vonsivers/word-clock/pics/IMG_20171213_205209.jpg

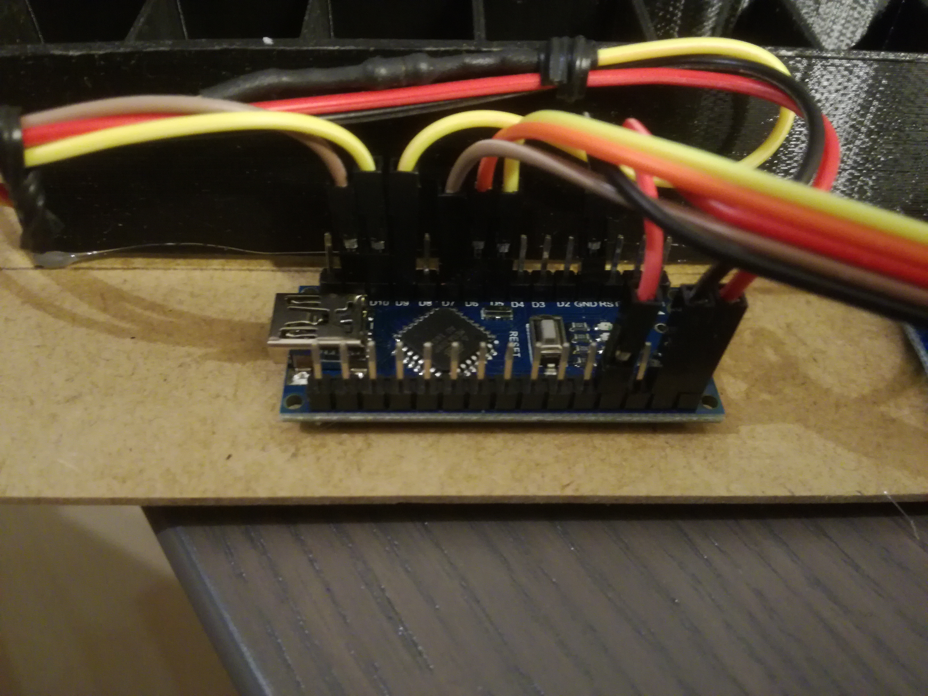
pics/IMG_20171213_205209.jpg
