vonsivers/word-clock/pics/IMG_20171213_215705.jpg

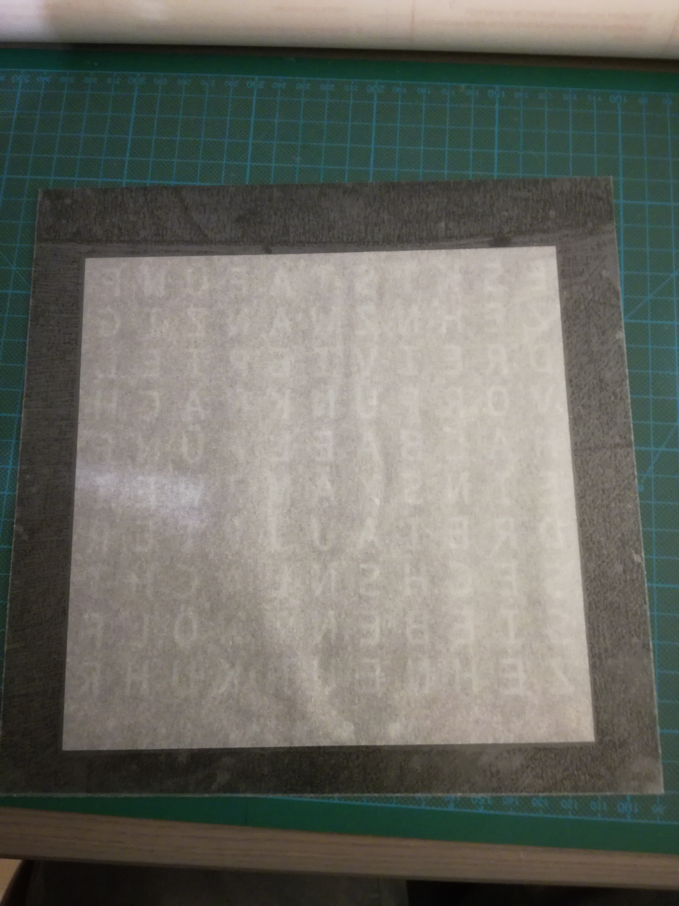
pics/IMG_20171213_215705.jpg
