vonsivers/word-clock/pics/IMG_20171213_201749.jpg

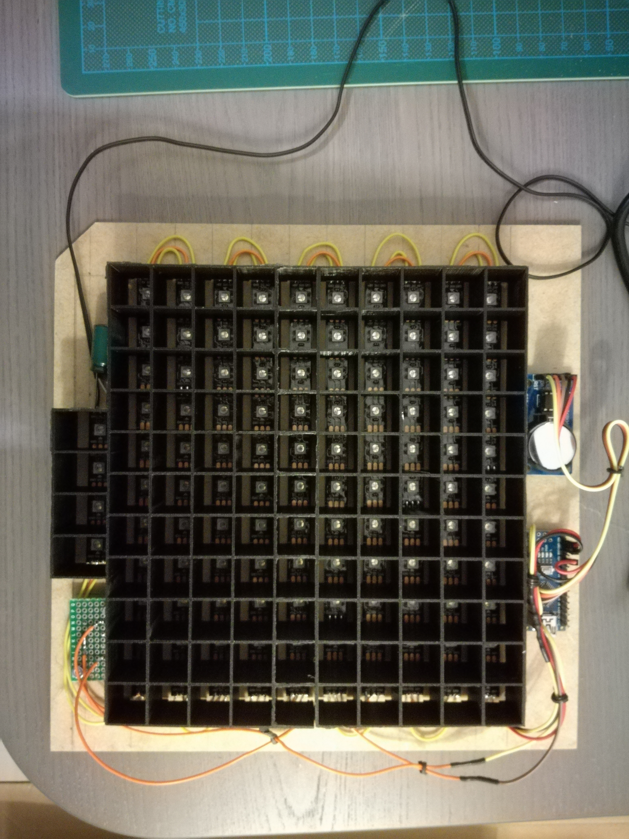
pics/IMG_20171213_201749.jpg
