vonsivers/word-clock/pics/IMG_20171213_205219.jpg

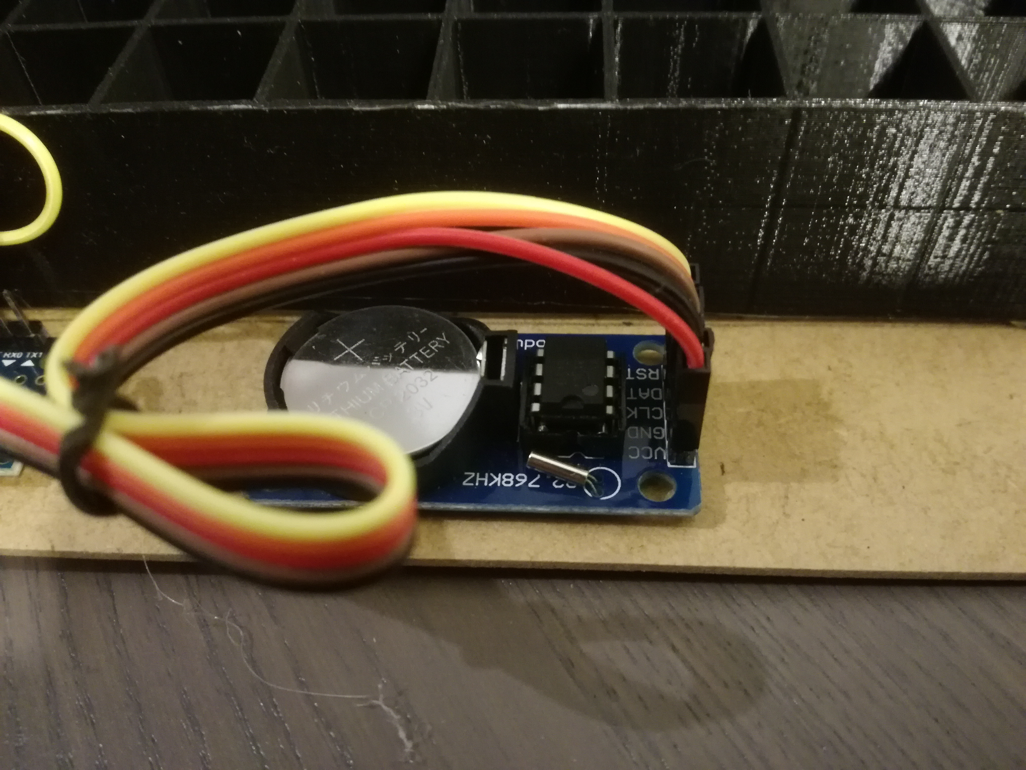
pics/IMG_20171213_205219.jpg
