vonsivers/word-clock/pics/IMG_20171213_211320.jpg

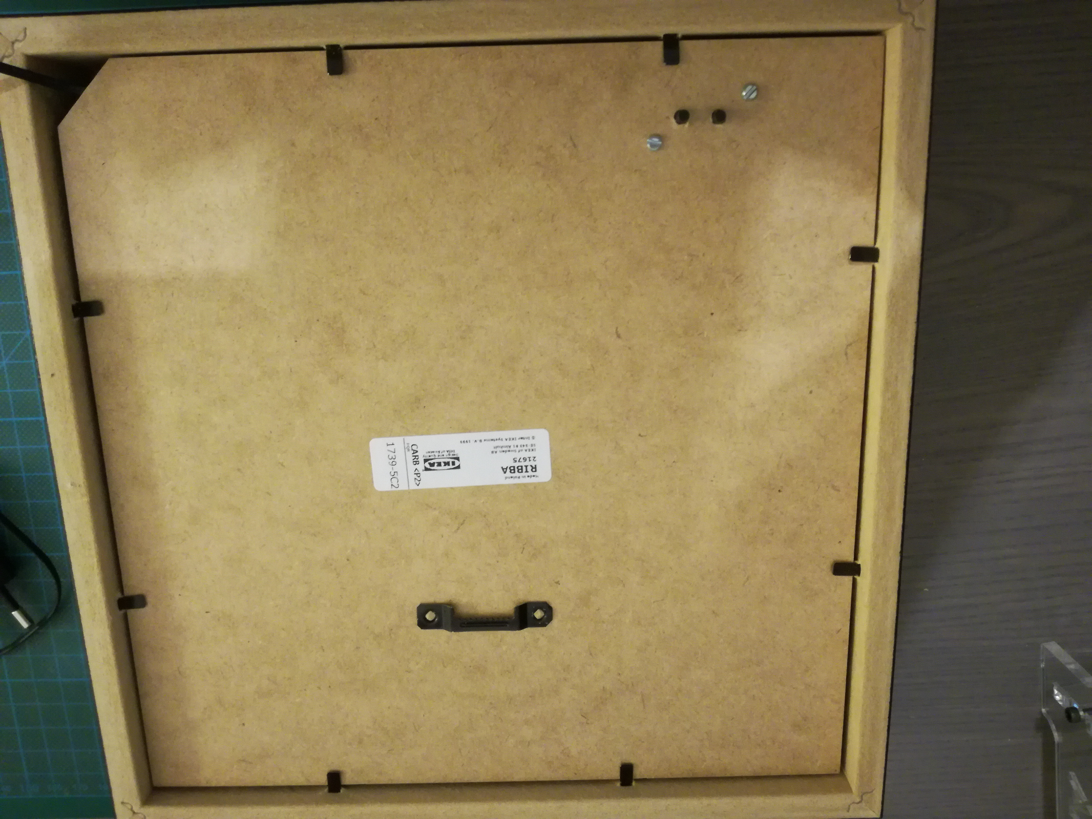
pics/IMG_20171213_211320.jpg
