vonsivers/word-clock/pics/IMG_20171214_003248.jpg

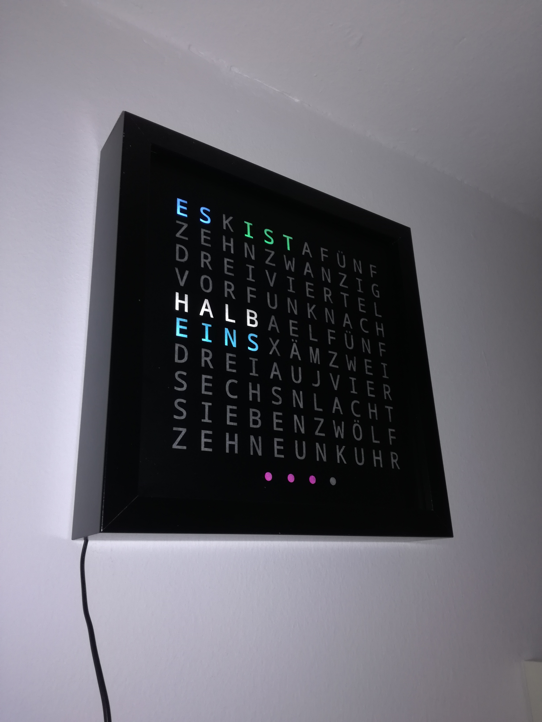
pics/IMG_20171214_003248.jpg
