vonsivers/word-clock/BoM.ods

Common Items
Quantity | Item | Source | Comments
114 pc (5 m strip) | WS2812B, 60 LEDs/m | https://www.amazon.de/BTF-LIGHTING-WS2812B-adressierbare-Streifen-NichtWasserdicht/dp/B01CDTEJBG
1 | IKEA Ribba (23 x 23 cm) | http://www.ikea.com/de/de/catalog/products/00378436/#/40378401
1 | ELCO, 1000 µF, 6.3V | https://www.conrad.de/de/elektrolyt-kondensator-radial-bedrahtet-35-mm-1000-f-63-v-20-o-x-h-8-mm-x-15-mm-europe-chemicon-eky-6r3ell102mh1-1505577.html | recommended to support PSU but not mandatory
1 | Resistor, 470 Ohm | https://www.conrad.de/de/kohleschicht-widerstand-470-axial-bedrahtet-0204-01-w-5-1-st-400211.html | anything between 300-500 Ohm, recommended but not mandatory
1 | Power Supply, 5V, >0.5 A | https://www.amazon.de/Wicked-Chili-Pro-Netzteil-Smartphone-schwarz/dp/B004GXUKD4
1 | USB cable | https://www.reichelt.de/?ACTION=3;ARTICLE=152673;SEARCH=usb%20textil%20kab
1 | Arduino Nano | https://www.amazon.de/XCSOURCE-Atmega-Controller-Arduino-TE359/dp/B015MGHH6Q
Options
1 | DS1302 RTC Module | https://www.amazon.de/DS1302-Echtzeituhr-Temperatursensor-Arduino-Raspberry/dp/B06XCR1WK2?s=computers
1 | DS3231 RTC Module | https://www.amazon.de/dp/B01M2B7HQB/ref=psdc_1626220031_t1_B06XCR1WK2 | alternative to DS1302 with better accuracy
2 | Push Button Dip Switch | https://www.conrad.de/de/drucktaster-12-vdc-005-a-1-x-ausein-yst-1103a-tastend-1-st-1386951.html | for setting time manually
1 | DCF77 Modul (EB6180B1COB77K5A1) | https://www.amazon.de/Empfangsmodul-Funkzeit-Funkuhr-Arduino-Antenne/dp/B014I7VUS6?s=aps | for automatic time setting, runs on max. 3.6 V
1 | DCF77 Modul (BN641138) | https://www.conrad.de/de/dcf-empfaenger-modul-641138-passend-fuer-serie-c-control-641138.html | more noisy than EB6180B1COB77K5A1 but runs on broad voltage range
1 | Arduino Micro Pro, 5V, 16 Mhz | https://www.amazon.de/dp/B075MD6591/ref=pe_3044161_189395811_TE_3p_dp_1 | One could also build the DCF77 clock without RTC using an arduino micro. The arduino micro clock has quarz crystal necessary for DCF signal filtering
