vonsivers/word-clock/technical drawings/grid.dxf

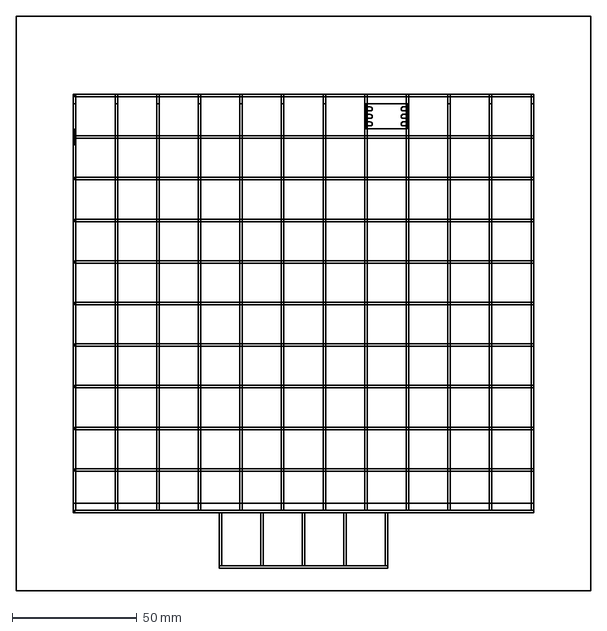
[picture p7: CAD file, 2018-01-08]
technical drawings/grid.dxf
230.0 x 230.0 mm
