vonsivers/word-clock/technical drawings/gitter.stl

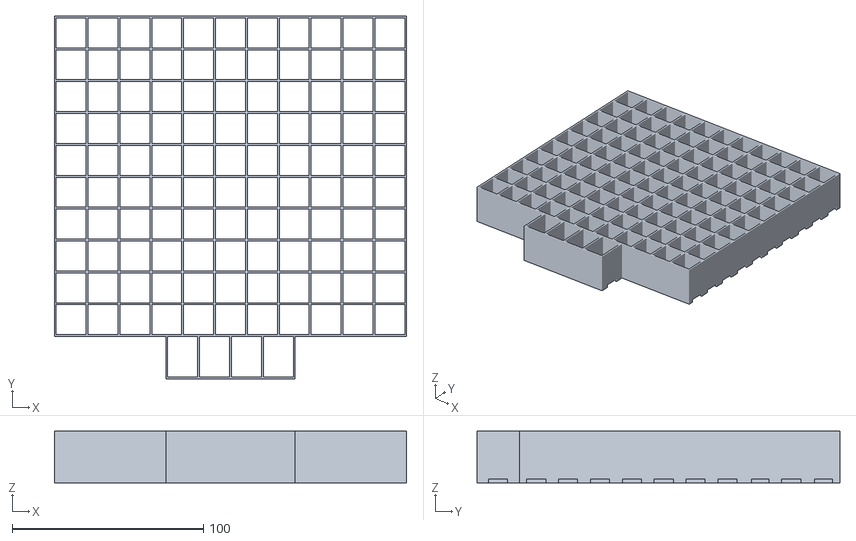
[picture p8: CAD file, 2018-01-08]
technical drawings/gitter.stl
184.3 x 189.8 x 27.0
