vonsivers/word-clock/technical drawings/gitter2_modified.stl

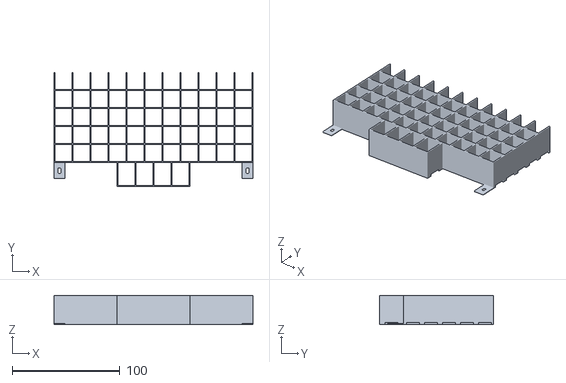
[picture p9: CAD file, 2018-01-04]
technical drawings/gitter2_modified.stl
184.3 x 105.5 x 27.0
