vonsivers/word-clock/technical drawings/gitter1_modified.stl

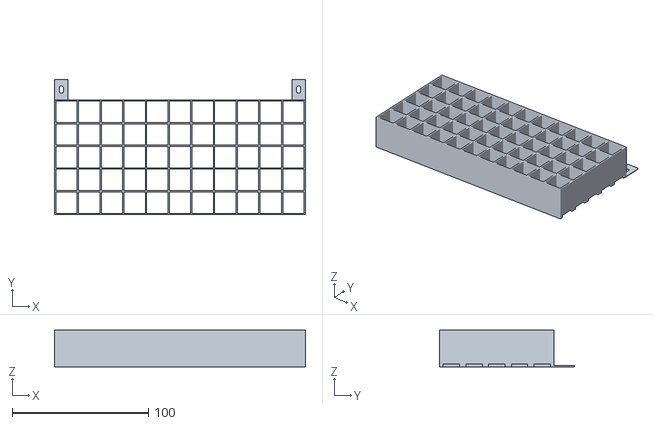
[picture p10: CAD file, 2018-01-04]
technical drawings/gitter1_modified.stl
184.3 x 99.3 x 27.0
