vonsivers/word-clock/technical drawings/gitter1.stl

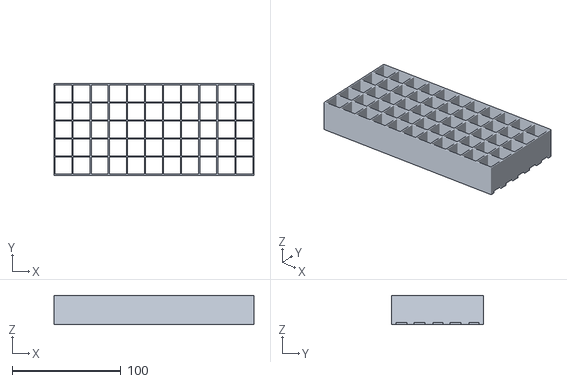
[picture p11: CAD file, 2017-12-27]
technical drawings/gitter1.stl
184.3 x 84.3 x 27.0
