vonsivers/word-clock/(list of files, cad)

Other CAD files:
technical drawings/gitter2.stl
