vonsivers/word-clock/DS3231-DCF77_word_clock/DS3231-DCF77 schematic.pdf

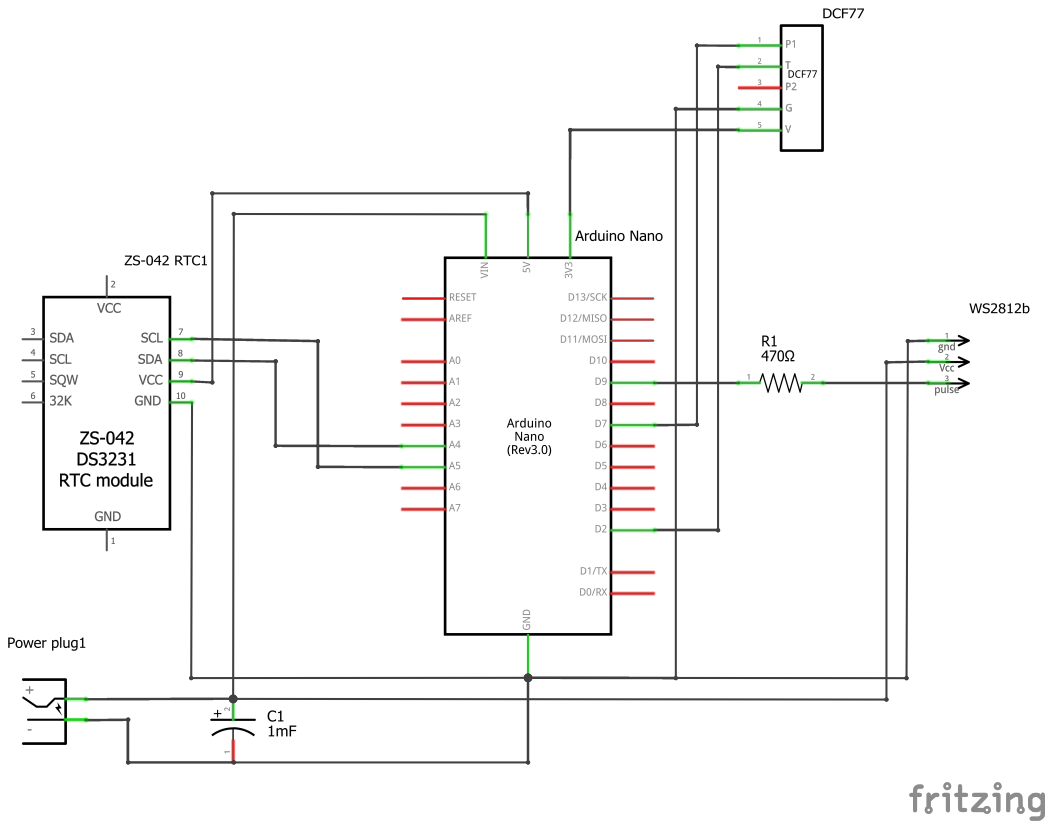
[picture p12: page 1]
