vonsivers/word-clock/DS1302_word_clock/word clock schematic.pdf

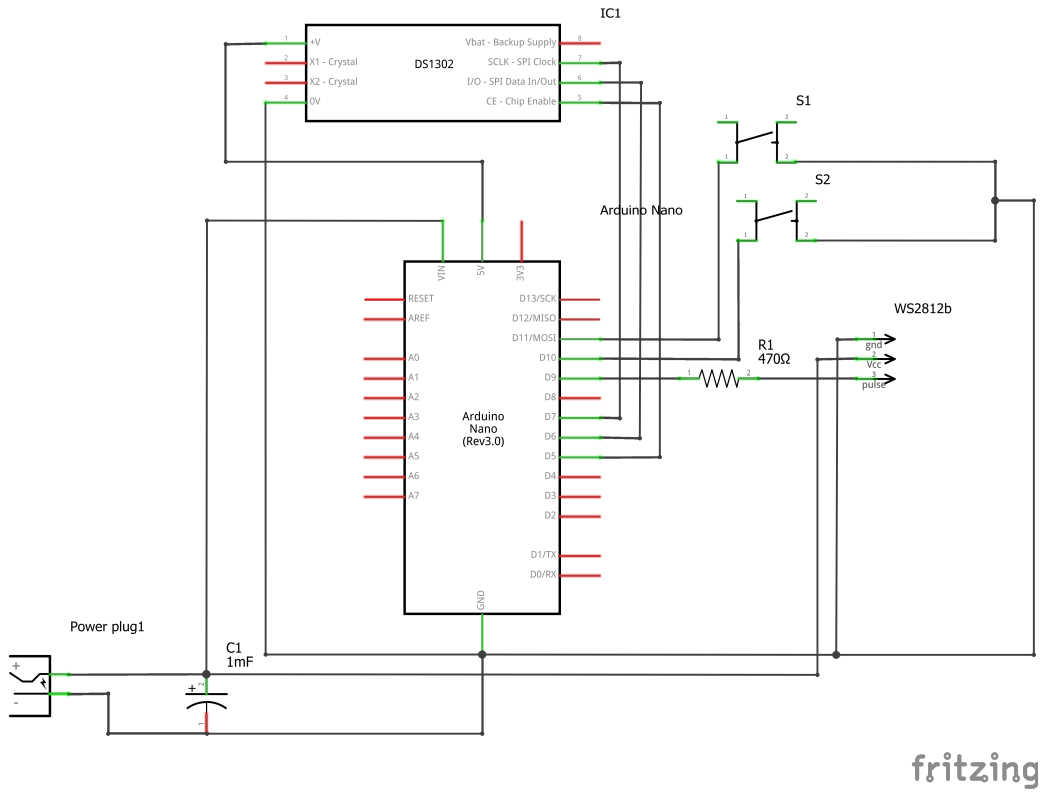
[picture p13: page 1]
