vonsivers/word-clock/technical drawings/word clock back panel drawing.pdf

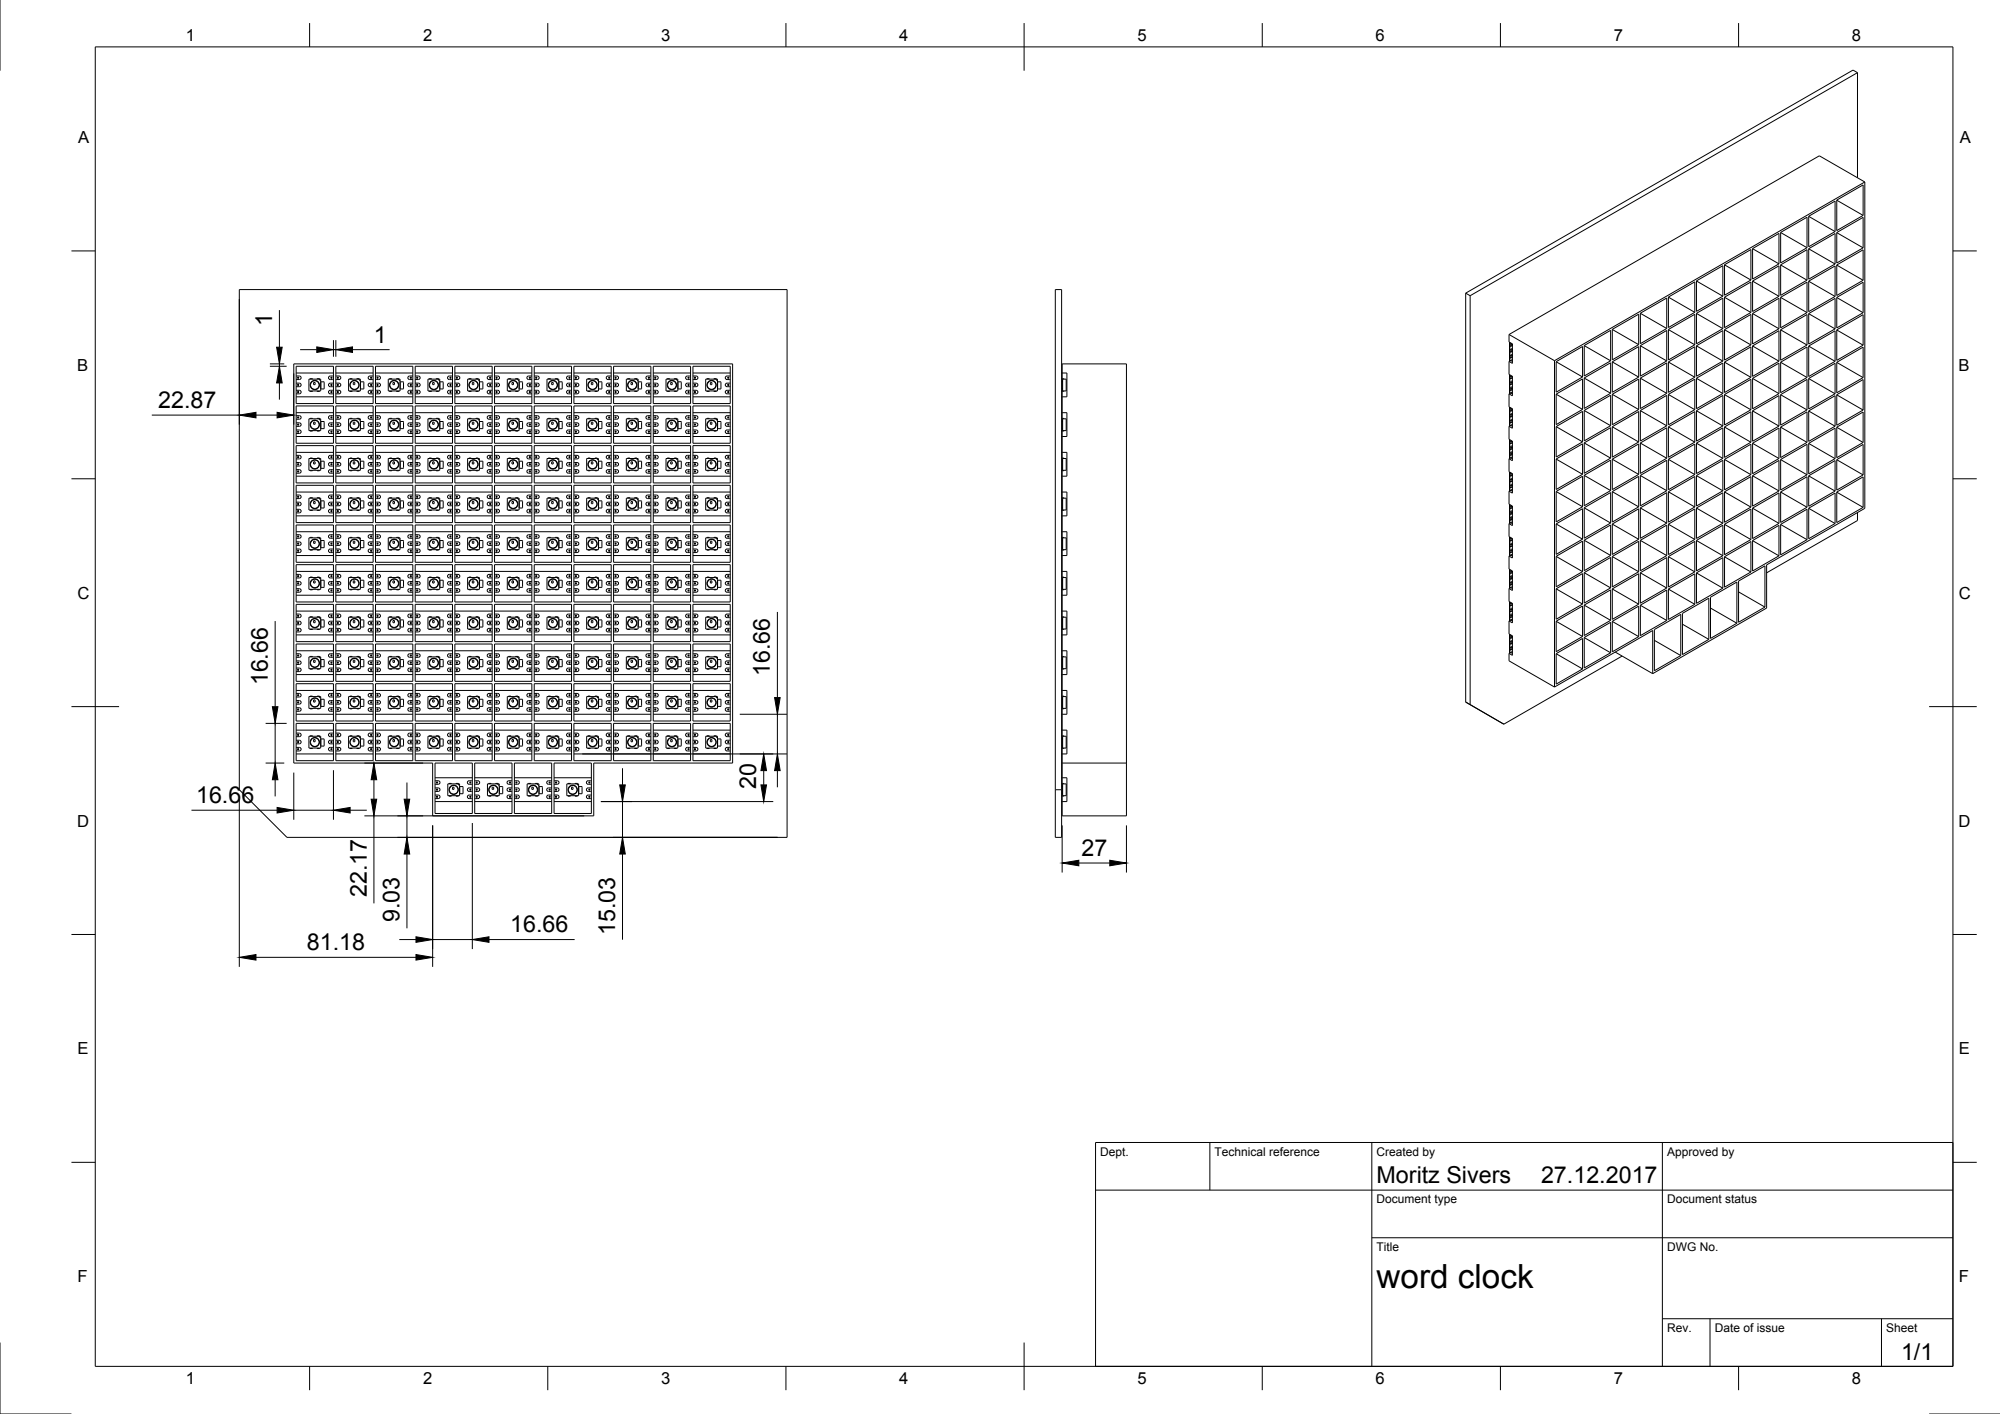
[picture p14: page 1]
Dept.; Technical reference; Created by; Approved by; Document type; Document status; Title; DWG No.; Rev.; Date of issue; Sheet; word clock; Moritz Sivers 9.03
