vonsivers/word-clock/(list of files, drawings)

Other design files:
DS1302_word_clock/word clock schematic.fzz
DS3231-DCF77_word_clock/DS3231-DCF77 schematic.fzz
