vonsivers/word-clock/DS3231-no_buttons/DS3231-no_buttons.ino

/* 
 *  Code by Moritz v. Sivers, Nov. 2020
 *  Word Clock with WS2812B and DS3231
 *  before uploading set the RTC by running the SetTime example from the DS1307RTC library  
 *  system time should be set to UTC
*/

// load libraries
#include <stdio.h>
#include <DS1307RTC.h>   // https://github.com/PaulStoffregen/DS1307RTC
#include <Timezone.h>    // https://github.com/JChristensen/Timezone
#include <Adafruit_NeoPixel.h>
#include <Adafruit_GFX.h>
#include <Adafruit_NeoMatrix.h>
#include <Wire.h>
#include <Time.h>
#include <TimeLib.h>    // https://github.com/PaulStoffregen/Time

#define DS3231_ADDRESS 0x68

// variables for LED strip
#define PIN            9
#define NUMPIXELS     114
#define BRIGHTNESS    127


// setup LED strip
Adafruit_NeoPixel pixels = Adafruit_NeoPixel(NUMPIXELS, PIN, NEO_GRB + NEO_KHZ800); 


// MATRIX DECLARATION:
// Parameter 1 = width of NeoPixel matrix
// Parameter 2 = height of matrix
// Parameter 3 = pin number (most are valid)
// Parameter 4 = matrix layout flags, add together as needed:
//   NEO_MATRIX_TOP, NEO_MATRIX_BOTTOM, NEO_MATRIX_LEFT, NEO_MATRIX_RIGHT:
//     Position of the FIRST LED in the matrix; pick two, e.g.
//     NEO_MATRIX_TOP + NEO_MATRIX_LEFT for the top-left corner.
//   NEO_MATRIX_ROWS, NEO_MATRIX_COLUMNS: LEDs are arranged in horizontal
//     rows or in vertical columns, respectively; pick one or the other.
//   NEO_MATRIX_PROGRESSIVE, NEO_MATRIX_ZIGZAG: all rows/columns proceed
//     in the same order, or alternate lines reverse direction; pick one.
//   See example below for these values in action.
// Parameter 5 = pixel type flags, add together as needed:
//   NEO_KHZ800  800 KHz bitstream (most NeoPixel products w/WS2812 LEDs)
//   NEO_KHZ400  400 KHz (classic 'v1' (not v2) FLORA pixels, WS2811 drivers)
//   NEO_GRB     Pixels are wired for GRB bitstream (most NeoPixel products)
//   NEO_RGB     Pixels are wired for RGB bitstream (v1 FLORA pixels, not v2)
Adafruit_NeoMatrix matrix = Adafruit_NeoMatrix(11, 10, PIN,
  NEO_MATRIX_TOP     + NEO_MATRIX_RIGHT +
  NEO_MATRIX_ROWS + NEO_MATRIX_ZIGZAG,
  NEO_GRB            + NEO_KHZ800);

// minute of last display update
int lastmin;


time_t c_time; // structure for current time

//Central European Time (Frankfurt, Paris)
TimeChangeRule CEST = {"CEST", Last, Sun, Mar, 2, 120};     //Central European Summer Time
TimeChangeRule CET = {"CET ", Last, Sun, Oct, 3, 60};       //Central European Standard Time
Timezone CE(CEST, CET);

TimeChangeRule *tcr;        //pointer to the time change rule, use to get the TZ abbrev

//Actual words as array variables
int ES[] = {10,9,-1};
int IST[] = {7,6,5,-1};
int FUENF_M[] = {3,2,1,0,-1};
int ZEHN_M[] = {11,12,13,14,-1};
int ZWANZIG[] = {15,16,17,18,19,20,21,-1};
int DREIVIERTEL[] = {32,31,30,29,28,27,26,25,24,23,22,-1};
int VIERTEL[] = {28,27,26,25,24,23,22,-1};
int VOR[] = {33,34,35,-1};
int NACH[] = {40,41,42,43,-1};
int HALB[] = {54,53,52,51,-1};
int ELF[] = {49,48,47,-1};
int FUENF_H[] = {47,46,45,44,-1};
int EIN[] = {55,56,57,-1};
int EINS[] = {55,56,57,58,-1};
int ZWEI[] = {62,63,64,65,-1};
int DREI[] = {76,75,74,73,-1};
int VIER[] = {69,68,67,66,-1};
int SECHS[] = {77,78,79,80,81,-1};
int ACHT[] = {84,85,86,87,-1};
int SIEBEN[] = {93,94,95,96,97,98,-1};
int ZWOELF[] = {92,91,90,89,88,-1};
int ZEHN_H[] = {99,100,101,102,-1};
int NEUN[] = {102,103,104,105,-1};
int UHR[] = {107,108,109,-1};

//define colours
uint32_t Black = pixels.Color(0,0,0);
uint32_t White = pixels.Color(255,255,255);
uint32_t Green = pixels.Color(0,255,0);
uint32_t Red = pixels.Color(255,0,0);
uint32_t Gold = pixels.Color(255,204,0);
uint32_t Grey = pixels.Color(30,30,30);
uint32_t Blue = pixels.Color(0,0,255);
//About colours
uint32_t whiteblue = pixels.Color(255,255,255);
uint32_t lightblue = pixels.Color(153,204,255);
uint32_t midblue = pixels.Color(0,102,204);
uint32_t darkblue = pixels.Color(0,0,255);
//coffee
uint32_t Brown = pixels.Color(153,102,051);
//ME!
uint32_t Pink = pixels.Color(255,153,153);


// setup everything
//
void setup()
{

  Wire.begin(); 
  
  pixels.begin();
  pixels.setBrightness(BRIGHTNESS);
  
  matrix.begin();
  matrix.setTextWrap(false);
  matrix.setBrightness(BRIGHTNESS);
  
  Serial.begin(9600);
  
  blank();
  test(); // LED test

  setSyncProvider(RTC.get);   // the function to get the time from the RTC
  if(timeStatus()!= timeSet)
    Serial.println("Unable to sync with the RTC");
  else
    Serial.println("RTC has set the system time");

  time_t utc = now();
  c_time = CE.toLocal(utc, &tcr);
  
  updateDisplay(false); // show time on display

  lastmin = minute(c_time); // initialize last update of display

}

//main loop
//
void loop()
{

  // get time
  time_t utc = now();
  c_time = CE.toLocal(utc, &tcr);


 // new year gimmick
 if ( (month(c_time) == 12) && (day(c_time)==31) && (hour(c_time)==23) && (minute(c_time)==59) && (abs(second(c_time)-50)<1) ) {
  newYear();
 }

  // show temperature on second 30 every two minutes
  if(abs(second(c_time)-30)<1 && minute(c_time)%2==0) {
    displayTemp();
    updateDisplay(false);
  }
  // show date on second 30 every other two minutes
  if(abs(second(c_time)-30)<1 && minute(c_time)%2==1) {
    displayDate();
    updateDisplay(false);
  }

  // update display every minute
  if((minute(c_time) > lastmin) || (minute(c_time) == 0 && lastmin == 59)) {
    updateDisplay(false);
    lastmin = minute(c_time);
  }

  delay(1000); // without buttons it is okay to update every second

}


// shows time on LED strip
//
void updateDisplay(bool timeset) {

  // number of dots 
  int ndots = (minute(c_time) % 5);

  // choose display effect
  int effect;
  if (timeset) {          // no effect when setting time
    effect = 0;
  }
  else {
    if (ndots==0) {       // scrolling effect every 5 minutes
      effect = 1;
    }
    else {
      effect = 2; // typing effect otherwise
    }
  }

  // blank all pixels
  blank();
  
   // for "typing" or no effect light up "ES IST" first
  if (effect == 2 || effect == 0) {
    lightup(ES,effect);
    lightup(IST,effect);
  }

  // light up minutes and hours
  switch (minute(c_time) / 5) {
                case 0:
                    // glatte Stunde
                    if (effect == 1) {
                      gocrazy();
                      blank();
                      lightup(UHR,effect);
                      setHours(hour(c_time),true,effect);
                    }
                    else {
                      setHours(hour(c_time),true,effect);
                      lightup(UHR,effect);
                    }
                    
                    break;
                case 1:
                    // 5 nach
                    if (effect == 1) {
                      setHours(hour(c_time),false,effect);
                      lightup(NACH,effect);
                      lightup(FUENF_M,effect);
                    }
                    else {
                      lightup(FUENF_M,effect);
                      lightup(NACH,effect);
                      setHours(hour(c_time),false,effect);
                    }
                    break;
                case 2:
                    // 10 nach
                    if (effect == 1) {
                      setHours(hour(c_time),false,effect);
                      lightup(NACH,effect);
                      lightup(ZEHN_M,effect);
                    }
                    else {
                      lightup(ZEHN_M,effect);
                      lightup(NACH,effect);
                      setHours(hour(c_time),false,effect);
                    }
                    break;
                case 3:
                    // viertel nach
                    if (effect == 1) {
                      setHours(hour(c_time),false,effect);
                      lightup(NACH,effect);
                      lightup(VIERTEL,effect);
                    }
                    else {
                      lightup(VIERTEL,effect);
                      lightup(NACH,effect);
                      setHours(hour(c_time),false,effect);
                    }
                    
                    break;
                case 4:
                    // 20 nach
                     if (effect == 1) {
                      setHours(hour(c_time),false,effect);
                      lightup(NACH,effect);
                      lightup(ZWANZIG,effect);
                     }
                     else {
                      lightup(ZWANZIG,effect);
                      lightup(NACH,effect);
                      setHours(hour(c_time),false,effect);
                     }
                    break;
                case 5:
                    // 5 vor halb
                     if (effect == 1) {
                      setHours(hour(c_time) + 1,false,effect);
                      lightup(HALB,effect);
                      lightup(VOR,effect);
                      lightup(FUENF_M,effect);
                     }
                     else {
                      lightup(FUENF_M,effect);
                      lightup(VOR,effect);
                      lightup(HALB,effect);
                      setHours(hour(c_time) + 1,false,effect);
                     }
                   
                    break;
                case 6:
                    // halb
                    if (effect == 1) {
                      setHours(hour(c_time) + 1,false,effect);
                      lightup(HALB,effect);
                    }
                    else {
                      lightup(HALB,effect);
                      setHours(hour(c_time) + 1,false,effect);
                    }
                    break;
                case 7:
                    // 5 nach halb
                    if (effect == 1) {
                      setHours(hour(c_time) + 1,false,effect);
                      lightup(HALB,effect);
                      lightup(NACH,effect);
                      lightup(FUENF_M,effect);
                    }
                    else {
                      lightup(FUENF_M,effect);
                      lightup(NACH,effect);
                      lightup(HALB,effect);
                      setHours(hour(c_time) + 1,false,effect);
                    }
                    
                    break;
                case 8:
                    // 20 vor
                     if (effect == 1) {
                      setHours(hour(c_time) + 1,false,effect);
                      lightup(VOR,effect);
                      lightup(ZWANZIG,effect);
                     }
                     else {
                      lightup(ZWANZIG,effect);
                      lightup(VOR,effect);
                      setHours(hour(c_time) + 1,false,effect);
                     }
                    break;
                case 9:
                    // viertel vor
                    if (effect == 1) {
                      setHours(hour(c_time) + 1,false,effect);
                      lightup(VOR,effect);
                      lightup(VIERTEL,effect);
                    }
                    else {
                      lightup(VIERTEL,effect);
                      lightup(VOR,effect);
                      setHours(hour(c_time) + 1,false,effect);
                    }
                    break;
                case 10:
                    // 10 vor
                    if (effect == 1) {
                      setHours(hour(c_time) + 1,false,effect);
                      lightup(VOR,effect);
                      lightup(ZEHN_M,effect);
                    }
                    else {
                      lightup(ZEHN_M,effect);
                      lightup(VOR,effect);
                      setHours(hour(c_time) + 1,false,effect);
                    }
                    break;
                case 11:
                    // 5 vor
                    if (effect == 1) {
                      setHours(hour(c_time) + 1,false,effect);
                      lightup(VOR,effect);
                      lightup(FUENF_M,effect);
                    }
                    else {
                      lightup(FUENF_M,effect);
                      lightup(VOR,effect);
                      setHours(hour(c_time) + 1,false,effect);
                    }
                    break;
            }

  // for scrolling effect light up "ES IST" last
  if (effect == 1) {
    lightup(ES,effect);
    lightup(IST,effect);
  }

  // always light up dots last
  setDots(ndots, timeset);

}




// print time to serial monitor
//
void printTime() {
  char buf[50];
  snprintf(buf, sizeof(buf), "%04d-%02d-%02d %02d:%02d:%02d",
           year(c_time), month(c_time), day(c_time),
           hour(c_time), minute(c_time), second(c_time));

  // Print the formatted string to serial so we can see the time.
  Serial.println(buf);
}


// display scrolling text when time is updated
//
void printUpdated() {
  const uint16_t color =  matrix.Color(255, 0, 0);
  matrix.setTextColor(color); 
  for (int i=0; i<2; i++) {
  int  x = matrix.width();
    while (x>-20) {
      matrix.fillScreen(0);
      matrix.setCursor(x, 2);
      matrix.print("******");
      matrix.show();
      x--;
      delay(100);
    }
  }
  
}


// new year count down
//
void newYear() {
  // count down from 10
  matrix.setCursor(0, 2);
  for (int i=10; i>0; --i) {
    char buf[1];
    sprintf(buf, "%d", i);
    const uint16_t color =  matrix.Color(random(0,255), random(0,255), random(0,255));
    matrix.setTextColor(color);
    matrix.fillScreen(0);
    matrix.print(buf);
    matrix.show();
    matrix.setCursor(3, 2);
    delay(1000);
  }
  gocrazy();
  // scroll text
  const uint16_t colors[] = { matrix.Color(255, 0, 0), matrix.Color(0, 255, 0), matrix.Color(0, 0, 255) };
  for (int i=0; i<3; i++) {
    int  x = matrix.width();
    matrix.setTextColor(colors[i]);
    while (x>-90) {
      matrix.fillScreen(0);
      matrix.setCursor(x, 2);
      matrix.print("HAPPY NEW YEAR!");
      matrix.show();
      x--;
      delay(100);
    }
  } 
}

// read temperature from DS3231
//
float tempDS3231() {
  float temp;
  int msb, lsb;
  Wire.beginTransmission(DS3231_ADDRESS);
  Wire.write(0x11); // DS3231 Register zu 11h
  Wire.endTransmission();
  Wire.requestFrom(DS3231_ADDRESS, 2); // 2 Byte Daten vom DS3231 holen
  msb = Wire.read();
  lsb = Wire.read();
  temp=((msb << 2) + (lsb >> 6) ) /4.0;
  return temp;
}

// display temperature as scrolling text
//
void displayTemp() {
  int temp = (int) tempDS3231() - 2; // temperature of chip is about 2° higher than RT
  char buf[6];
  sprintf(buf, "%d", temp); 
  int red = map(temp, 10, 30, 0, 255);
  int blue = map(temp, 30, 10, 0, 255);
  const uint16_t color =  matrix.Color(red, 0, blue);
  matrix.setTextColor(color); 
  for (int i=0; i<2; i++) {
  int  x = matrix.width();
    while (x>-20) {
      matrix.fillScreen(0);
      matrix.setCursor(x, 2);
      matrix.print(buf);
      matrix.fillRect(x+12, 2, 2, 2, color);
      matrix.setCursor(x+15, 2);
      matrix.print("C");
      matrix.show();
      x--;
      delay(110);
    }
  }
}

// display date as scrolling text
//
void displayDate() {
  char datestring[32];
  sprintf(datestring, "%d.%d.%d", day(c_time),month(c_time),year(c_time));  
  const uint16_t color =  matrix.Color(random(255), random(255), random(255));
  matrix.setTextColor(color); 
  for (int i=0; i<2; i++) {
  int  x = matrix.width();
    while (x>-65) {
      matrix.fillScreen(0);
      matrix.setCursor(x, 2);
      matrix.print(datestring);
      matrix.show();
      x--;
      delay(110);
    }
  }
  
}

// light up hours on display
//
void setHours(byte c_hour, boolean glatt, int effect) {
    switch (c_hour) {
                case 0:
                case 12:
                case 24:
                    lightup(ZWOELF,effect);
                    break;
                case 1:
                case 13:
                    if (glatt) {
                        lightup(EIN,effect);
                    } else {
                        lightup(EINS,effect);
                    }
                    break;
                case 2:
                case 14:
                   lightup(ZWEI,effect);
                    break;
                case 3:
                case 15:
                    lightup(DREI,effect);
                    break;
                case 4:
                case 16:
                    lightup(VIER,effect);
                    break;
                case 5:
                case 17:
                    lightup(FUENF_H,effect);
                    break;
                case 6:
                case 18:
                    lightup(SECHS,effect);
                    break;
                case 7:
                case 19:
                    lightup(SIEBEN,effect);
                    break;
                case 8:
                case 20:
                    lightup(ACHT,effect);
                    break;
                case 9:
                case 21:
                    lightup(NEUN,effect);
                    break;
                case 10:
                case 22:
                    lightup(ZEHN_H,effect);
                    break;
                case 11:
                case 23:
                    lightup(ELF,effect);
                    break;
            }            
}

// light up the dots
//
void setDots(int nDots, bool timeset) {
  //Serial.print("Number of dots: ");
  //Serial.println(nDots);
  uint32_t Colour = pixels.Color(random(0,255),random(0,255),random(0,255)); //choose random color
  for (int i = 0; i < nDots; i++) {
    pixels.setPixelColor(113-i, Colour);
    pixels.show();
    if (!timeset) delay(50);
    //Serial.print("lighting up pixel ");
    //Serial.println(i);
  }
  
}

// light up word on display
//
void lightup(int Word[], int effect) {
  uint32_t Colour = pixels.Color(random(0,255),random(0,255),random(0,255)); //choose random color
  for (int i = 0; i < 12; i++) {
    if(Word[i]==-1) break;
    if (effect==2) {
      pixels.setPixelColor(Word[i], Colour);
      pixels.show();
      delay(50);
    }
    else if (effect==1) {
      int row = Word[i]/11;
      int column;
      if ((row % 2) == 0) {
        column = Word[i]-row*11;
      }
      else {
        column = row*11+10-Word[i];
      }
      for (int j=0; j<row; j++) {
        int x;
        if ((j%2) == 0) {
          x = column+j*11;
        }
        else {
          x = j*11+10-column;
        }
        pixels.setPixelColor(x, Colour);
        pixels.show();
        delay(30);
        pixels.setPixelColor(x, Black);
        pixels.show();
      }
      pixels.setPixelColor(Word[i], Colour);
      pixels.show();
    }
    else {
      pixels.setPixelColor(Word[i], Colour);
      pixels.show();
    }
  }
}


// clear all pixels
//
void blank() {
for (int x = 0; x < NUMPIXELS; ++x) {
  pixels.setPixelColor(x, Black);
}
  pixels.show();

}

// wipe pixels
//
void wipe() {

  for (int x = 0; x < NUMPIXELS; ++x) {
    pixels.setPixelColor(x, Blue);
    delay(10);
    pixels.show();
    }
  delay(50);  
  for (int x = NUMPIXELS; x > -1; --x) {
    pixels.setPixelColor(x, Black);
    delay(10);
    pixels.show();
  }
  
   for (int x = 0; x < NUMPIXELS; ++x) {
    pixels.setPixelColor(x, Green);
    delay(10);
    pixels.show();
    }
  delay(50);  
  for (int x = NUMPIXELS; x > -1; --x) {
    pixels.setPixelColor(x, Black);
    delay(10);
    pixels.show();
  }
  
   for (int x = 0; x < NUMPIXELS; ++x) {
    pixels.setPixelColor(x, Red);
    delay(10);
    pixels.show();
   }
  delay(50);  
  for (int x = NUMPIXELS; x > -1; --x) {
    pixels.setPixelColor(x, Black);
    delay(10);
    pixels.show();
  }
  
  blank();

}


// display test
//
void test() {
  Serial.println("Running LED test...");
  blank();
  wipe();
  blank();
}

// light up pixels randomly
//
void gocrazy() {
  for(int i=0; i<50; i++) {
    int n = random(0,NUMPIXELS);
    for (int j=0; j<n; j++) {
      int x = random(0,NUMPIXELS);
      uint32_t Colour = pixels.Color(random(0,255),random(0,255),random(0,255)); //choose random color
      pixels.setPixelColor(x, Colour);
    }
    pixels.show();
    int t = random(0,10);
    delay(t);
    n = random(0,NUMPIXELS);
    for (int j=0; j<n; j++) {
      int x = random(0,NUMPIXELS);
      pixels.setPixelColor(x, Black);
    }
    pixels.show();
  }
}

// flash pixels
//
void flash() {

blank();
for (int y = 0; y< 10; ++y) {
    for (int x = 0; x < NUMPIXELS; x=x+2) {
      pixels.setPixelColor(x, Pink);
    }
    //pixels.setBrightness(BRIGHTNESS);
    pixels.show();
    delay(50);
    blank();
    delay(50);

    for (int x = 1; x < NUMPIXELS; x=x+2) {
      pixels.setPixelColor(x, Pink);  
    }
    //pixels.setBrightness(BRIGHTNESS);
    pixels.show();
    delay(50);
    blank();
    delay(50);
}
blank();
}
