vonsivers/word-clock/(commit log)

2017-12-14 bugfix
    "ES IST" not showing when timeset
    [DS1302_word_clock.ino]
2017-12-27 added drawings
    [BoM.ods, gitter1.stl, gitter2.stl, word clock schematic.fzz]
2018-01-04 added modified grid stl files
    [gitter1_modified.stl, gitter2_modified.stl]
2018-01-08 added alternative clock versions
    [BoM.ods, DS3231-DCF77 schematic.fzz, gitter.stl, gitter1.stl, gitter1_modified.stl, gitter2.stl, gitter2_modified.stl, grid.dxf]
2018-01-10 solved DCF signal search problem, updated BoM
    LEDs switched off during signal search
    [BoM.ods, word clock schematic.fzz]
2020-11-15 added version with no buttons
